sqra/iot-github-frame/docs/IoTGitHubFrame_schematic.pdf

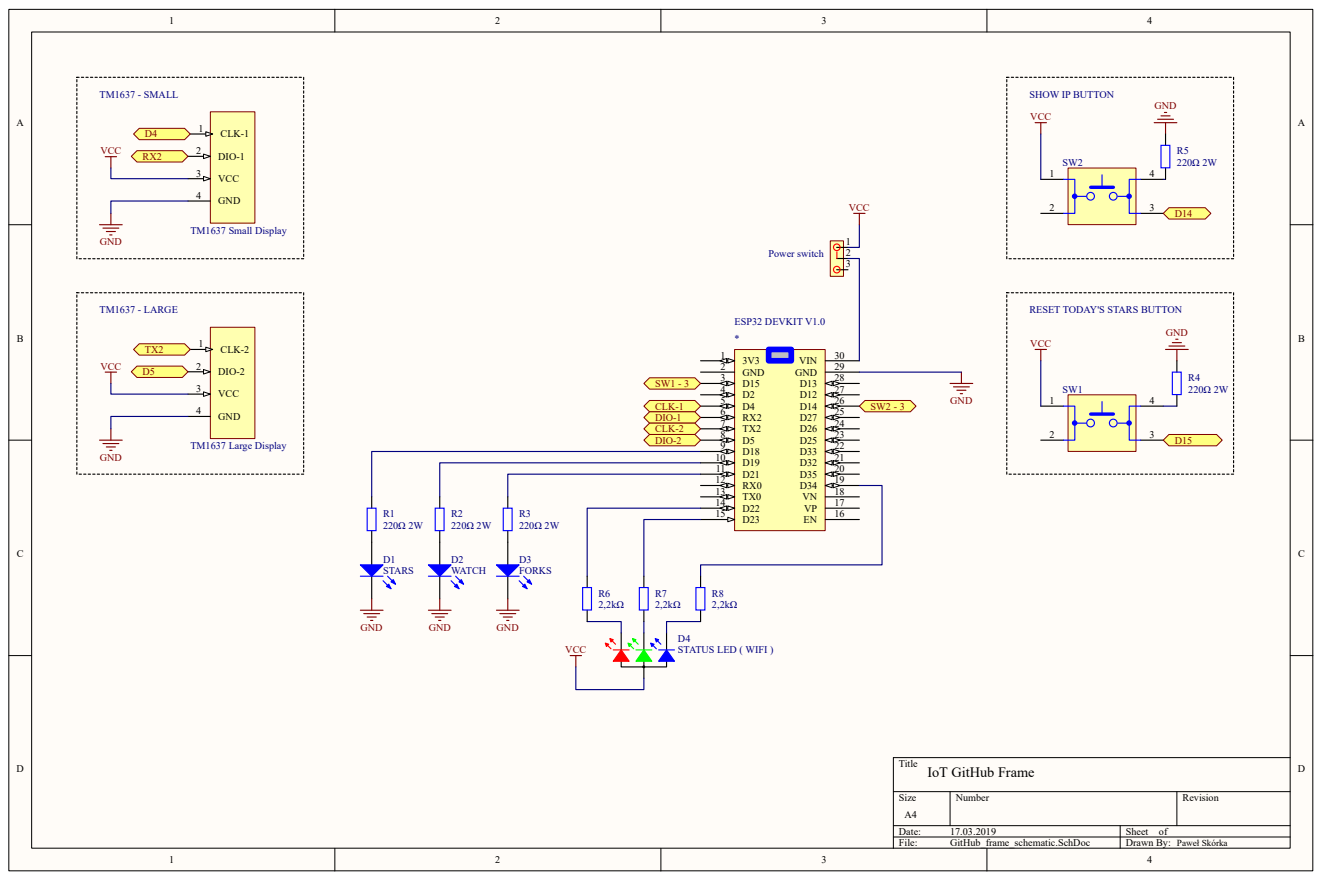
[picture p14: page 1]

RESET TODAY'S STARS BUTTON
