sqra/iot-github-frame/printouts/drilling-template-side-buttons.pdf

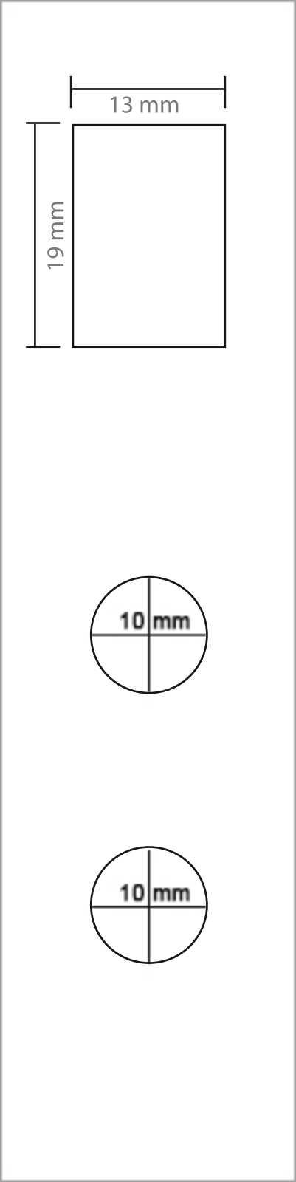
[picture p15: page 1]

19mm

13mm
