sqra/iot-github-frame/printouts/drilling-template-back.pdf

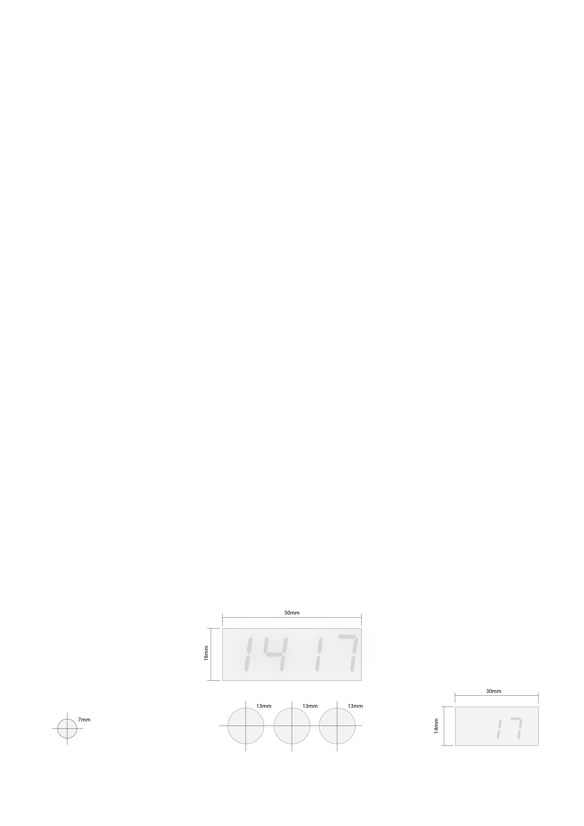
[picture p16: page 1]
