sqra/iot-github-frame/(commit log)

2019-03-15 More files for print
2019-03-17 Support for the missing configuration
    [IoTGithubFrame.ino, texts.h]
